eorzes/PSLink_v2/PCB-3D.png

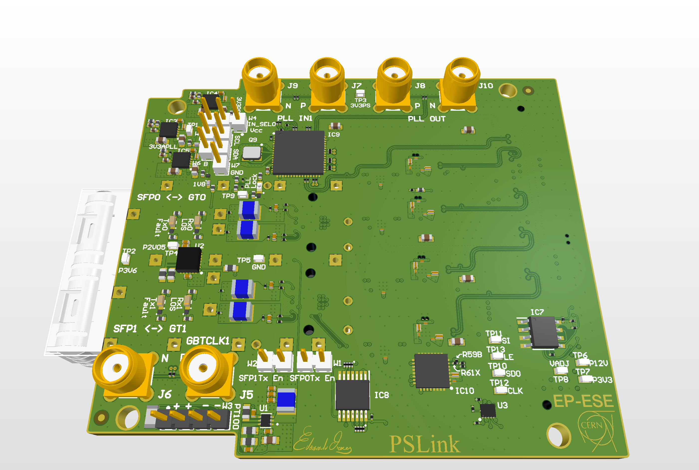
PCB-3D.png
