eorzes/PSLink_v2/PCB-3D-bot.png

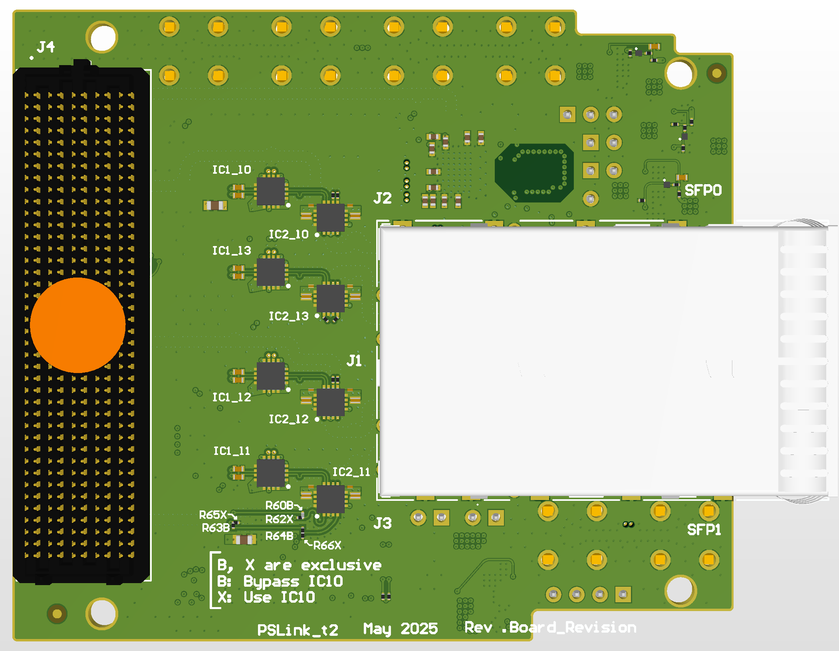
PCB-3D-bot.png
