eorzes/PSLink_v2/BOM_PSLink_v2.csv

Designator | Quantity | Manufacturer | Description | Comment | Footprint | Package | LibRef
C1_l0, C1_l1, C1_l2, C1_l3, C3_l0, C3_l1, C3_l2, C3_l3, C5_l0, C5_l1, C5_l2, C5_l3, C8_l0, C8_l1, C8_l2, C8_l3, C19, C32, C41, C104 | 20 |  | LLL153C70G474ME17 | 470nF | CAPC0510X04N |  | Capacitor - non polarized
C2_l0, C2_l1, C2_l2, C2_l3, C4_l0, C4_l1, C4_l2, C4_l3, C6_l0, C6_l1, C6_l2, C6_l3, C9_l0, C9_l1, C9_l2, C9_l3, C12_l0, C12_l1, C12_l2, C12_l3, C13_l0, C13_l1, C13_l2, C13_l3, C105 | 25 |  | LLL03TR61E333KE01 | 33nF | LLL03TR61E333KE01 |  | Capacitor - non polarized
C7_l0, C7_l1, C7_l2, C7_l3, C15, C16, C26, C27, C28, C37, C38, C101, C102, C103 | 14 | GENERIC | C1608X5R1E106M080AC | 10uF | CAPC1608X87N |  | CC0603_10UF_6.3V_20%_X5R
C10_l0, C10_l1, C10_l2, C10_l3, C11_l0, C11_l1, C11_l2, C11_l3, C18, C24, C25, C31, C34, C35, C36, C40, C46, C49, C52, C55 | 20 |  | GRM155R60J226ME11 | 22uF | MURATA_HI_DENSITY_0402_CAP |  | C0402-22uF-high-density
C14, C45, C47, C48, C50, C51, C53, C54, C56, C57, C58, C59, C60, C61, C62, C63, C64, C65, C66, C67, C68, C69, C70, C71, C72, C73, C74, C75, C76, C77, C78, C79, C80, C81, C82, C83, C84, C85, C86, C91, C92, C106, C107 | 43 |  | GRM033R61C104KE14 | 100nF | MURATA_HI_DENSITY_0201 |  | C0201-100nF-high-density
C17, C20, C30, C33, C39, C42, C87, C88, C89, C90, C93, C94, C95, C96, C97, C98, C99, C100 | 18 | GENERIC | GRM153B30J105ME15 | 1uF | CAPC1005X55N |  | CC0402_1UF_16V_10%_X5R
C21, C22, C23 | 3 |  | GRM155R71E104KE14 | 100nF | MURATA_HI_DENSITY_0402_CAP |  | C0402-22uF-high-density
C29, C43, C44 | 3 |  | C0402C220J4GACTU | 22pF | MURATA_HI_DENSITY_0402_CAP |  | C0402-22uF-high-density
D1, D2, D3 | 3 |  | Led Green 0402 2mA 2.65V 40mcd 102mW | APHHS1005LZGCK-V | LED_APHHS1005LZGCK-V | 0402 Kingbright Corporation | APHHS1005LZGCK-V
D4 | 1 |  | LED | APTD1608LVBC_D | LEDC1608X110N |  | APTD1608LVBC_D
FTG1, FTG2, FTG3, FTG4 | 4 |  | Fiducial Target | Use only in PCB | FIDUCIAL_TOP_C100-200 |  | FIDUCIAL_TARGET_C100-200
IC1_l0, IC1_l1, IC1_l2, IC1_l3 | 4 |  | Integrated Circuit | NB7V52MMNG | QFN50P300X300X100-17N |  | NB7V52MMNG
IC2_l0, IC2_l1, IC2_l2, IC2_l3 | 4 |  | Integrated Circuit | NB7VQ14MMNHTBG | QFN50P300X300X100-17N |  | NB7VQ14MMNHTBG
IC3, IC4, IC5 | 3 |  | Integrated Circuit | ADP7159ACPZ-04-R7 | SON50P300X300X85-11N-D |  | ADP7159ACPZ-04-R7
IC6 | 1 |  | 32207590 - PT100 - 1206 - 0.3degC - -50/130 | 32207590 | PT100 |  | PT100
IC7 | 1 |  | Integrated Circuit | M24C02-RMN6TP | SOIC127P600X175-8N |  | M24C02-RMN6TP
IC8 | 1 |  | Integrated Circuit | TCA9543APWR | SOP65P640X120-14N |  | TCA9543APWR
IC9 | 1 |  | Integrated Circuit | SI5345B-D-GM | QFN50P900X900X90-65N-D |  | SI5345B-D-GM
IC10 | 1 |  | Integrated Circuit | PE44820B-X | QFN50P500X500X90-33N-D |  | PE44820B-X
J1 | 1 |  | Connector | 2007263-1_NP | 20072631_NP |  | 2007263-1_NP
J2, J3 | 2 | TYCO ELECTRONICS | 20 Position SFP+ Connector (Small Form-factor Pluggable) | SFP+ | TYCO_1888247-1 |  | TYCO_1888247-1
J4 | 1 |  |  | SEAM-40-03.5-S-10-2-A-K-TR | SAMTEC_SEAM-40-03.5-S-10-2-A-K-TR | None | SEAM-40-03.5-S-10-2-A-K-TR
J5, J6, J7, J8, J9, J10 | 6 | SAMTEC |  | SMA | SAMTEC_SMA-J-P-H-ST-MT1 |  | SAMTEC_SMA-J-P-H-ST-MT1
L1, L2, L3, L4, L5 | 5 |  | Inductor | 4.7uH | DFE322520FD1R0MP2 |  | DFE322520FD-4R7M=P2
LED1, LED2, LED3, LED4 | 4 |  | Led Red 0603 2mA 1.8V 50mcd 84mW | APTD1608LSECKJ3-PF | LED_APTD1608LSECKJ3-PF_KNB |  | APTD1608LSECKJ3-PF
Q1, Q2, Q3, Q4, Q5, Q6, Q7, Q8, Q10 | 9 |  | MOSFET (N-Channel) | CSD15380F3 | CSD15380F3 |  | CSD15380F3
Q9 | 1 | KYOCERA | Crystal 4 pins 1=XTAL Control 2=GND3=XTAL 4=GND | 48MHz | XTAL_KYOCERA_CX3225SB |  | XTAL_48MHZ_KYOCERA_CX3225SB48000D0FPJC1
R1, R4, R21, R24, R25, R27 | 6 |  | Resistor 10k | 1M | MURATA_HI_DENSITY_0201 |  | R0201-100ohm-high-density
R2, R22, R26, R50, R51, R52 | 6 |  | Resistor | 100O | MURATA_HI_DENSITY_0201 |  | R0201-100ohm-high-density
R3, R8, R15, R57 | 4 | GENERIC | Resistor - 1% | 750 | RESC1005X40N |  | R0402_750R_1%_0.0625W_100PPM
R5, R11 | 2 | GENERIC | Resistor - 1% | 47k | RESC1005X40N |  | R0402_47K_1%_0.0625W_100PPM
R6, R12 | 2 | GENERIC | Resistor - 1% | 27k | RESC1005X40N |  | R0402_27K_1%_0.0625W_100PPM
R7, R13, R16 | 3 | GENERIC | Resistor - 1% | 100k | RESC1608X55N |  | R0603_30K_1%_0.1W_100PPM
R9 | 1 | GENERIC | Resistor - 1% | 150k | RESC1608X55N |  | R0603_150K_1%_0.1W_100PPM
R10 | 1 | GENERIC | Resistor - 1% | 30k | RESC1608X55N |  | R0603_30K_1%_0.1W_100PPM
R14 | 1 | GENERIC | Resistor - 1% | 243k | RESC1608X55N |  | R0603_30K_1%_0.1W_100PPM
R17, R23, R30, R31, R32, R35, R38, R39, R40, R43, R44, R45, R46, R47, R48, R49, R53, R54 | 18 |  | Resistor 10k | 10k | MURATA_HI_DENSITY_0201 |  | R0201-100ohm-high-density
R18, R33, R34, R41, R42, R58 | 6 | GENERIC | Resistor - 1% | 200k | RESC1005X40N |  | R0402_200K_1%_0.0625W_100PPM
R19 | 1 | GENERIC | Resistor - 1% | 20k | RESC1005X40N |  | R0402_20K_1%_0.0625W_100PPM
R20 | 1 | GENERIC | Resistor - 1% | 5k1 | RESC1005X40N |  | R0402_5K1_1%_0.0625W_100PPM
R28, R29, R36, R37 | 4 | GENERIC | Resistor - 1% | 1k5 | RESC1005X40N |  | R0402_1K5_1%_0.0625W_100PPM
R55, R56 | 2 | GENERIC | Resistor - 1% | 22 | RESC1005X40N |  | R0402_22R_1%_0.0625W_100PPM
R59B, R60B, R61X, R62X, R63B, R64B | 6 |  | Resistor | 0O | MURATA_HI_DENSITY_0201 |  | R0201-100ohm-high-density
R65X, R66X | 2 |  | Resistor | 50O | MURATA_HI_DENSITY_0201 |  | R0201-100ohm-high-density
RN1, RN2 | 2 |  | Resistor Network (8-Pin) 10k | EXB-U18103JX | EXBU18 |  | EXB-U18103JX
TP1, TP2, TP3, TP4, TP5, TP6, TP7, TP8, TP9, TP10, TP11, TP12, TP13 | 13 |  |  | RCU-0C | TP+195X110 | None | RCU-0C
U1 | 1 |  | No Description Available | TPS563203DRLR | SOT_07SDRLR_TEX |  | TPS563203DRLR
U2 | 1 |  | No Description Available | TPSM82866AA0SRDJR | RDJ0023A-MFG |  | XPSM82866AA0SRDJR
U3 | 1 |  | No Description Available | TXB0104RUTR | RUT12_TEX |  | TXB0104RUTR
W1, W2, W5, W6 | 4 | SAMTEC | 2 Mini Wire-Wrap Contact Strip Header | Header 2 | SAMTEC_HTSW-102-23-L-S |  | SAMTEC_HTSW-102-23-L-S
W3 | 1 | SAMTEC | 4 Mini Wire-Wrap Contact Strip Header | Header 4 | SAMTEC_HTSW-104-23-L-S |  | SAMTEC_HTSW-104-23-L-S
W4 | 1 | SAMTEC | 3 Mini Wire-Wrap Contact Strip Header | Header 3 | SAMTEC_HTSW-103-23-L-S |  | SAMTEC_HTSW-103-23-L-S
W7 | 1 | SAMTEC | Single Mini Wire-Wrap Contact | Header 1 | SAMTEC_HTSW-101-23-L-S |  | SAMTEC_HTSW-101-23-L-S
