eorzes/PSLink_v2/PSLink_v2.pdf

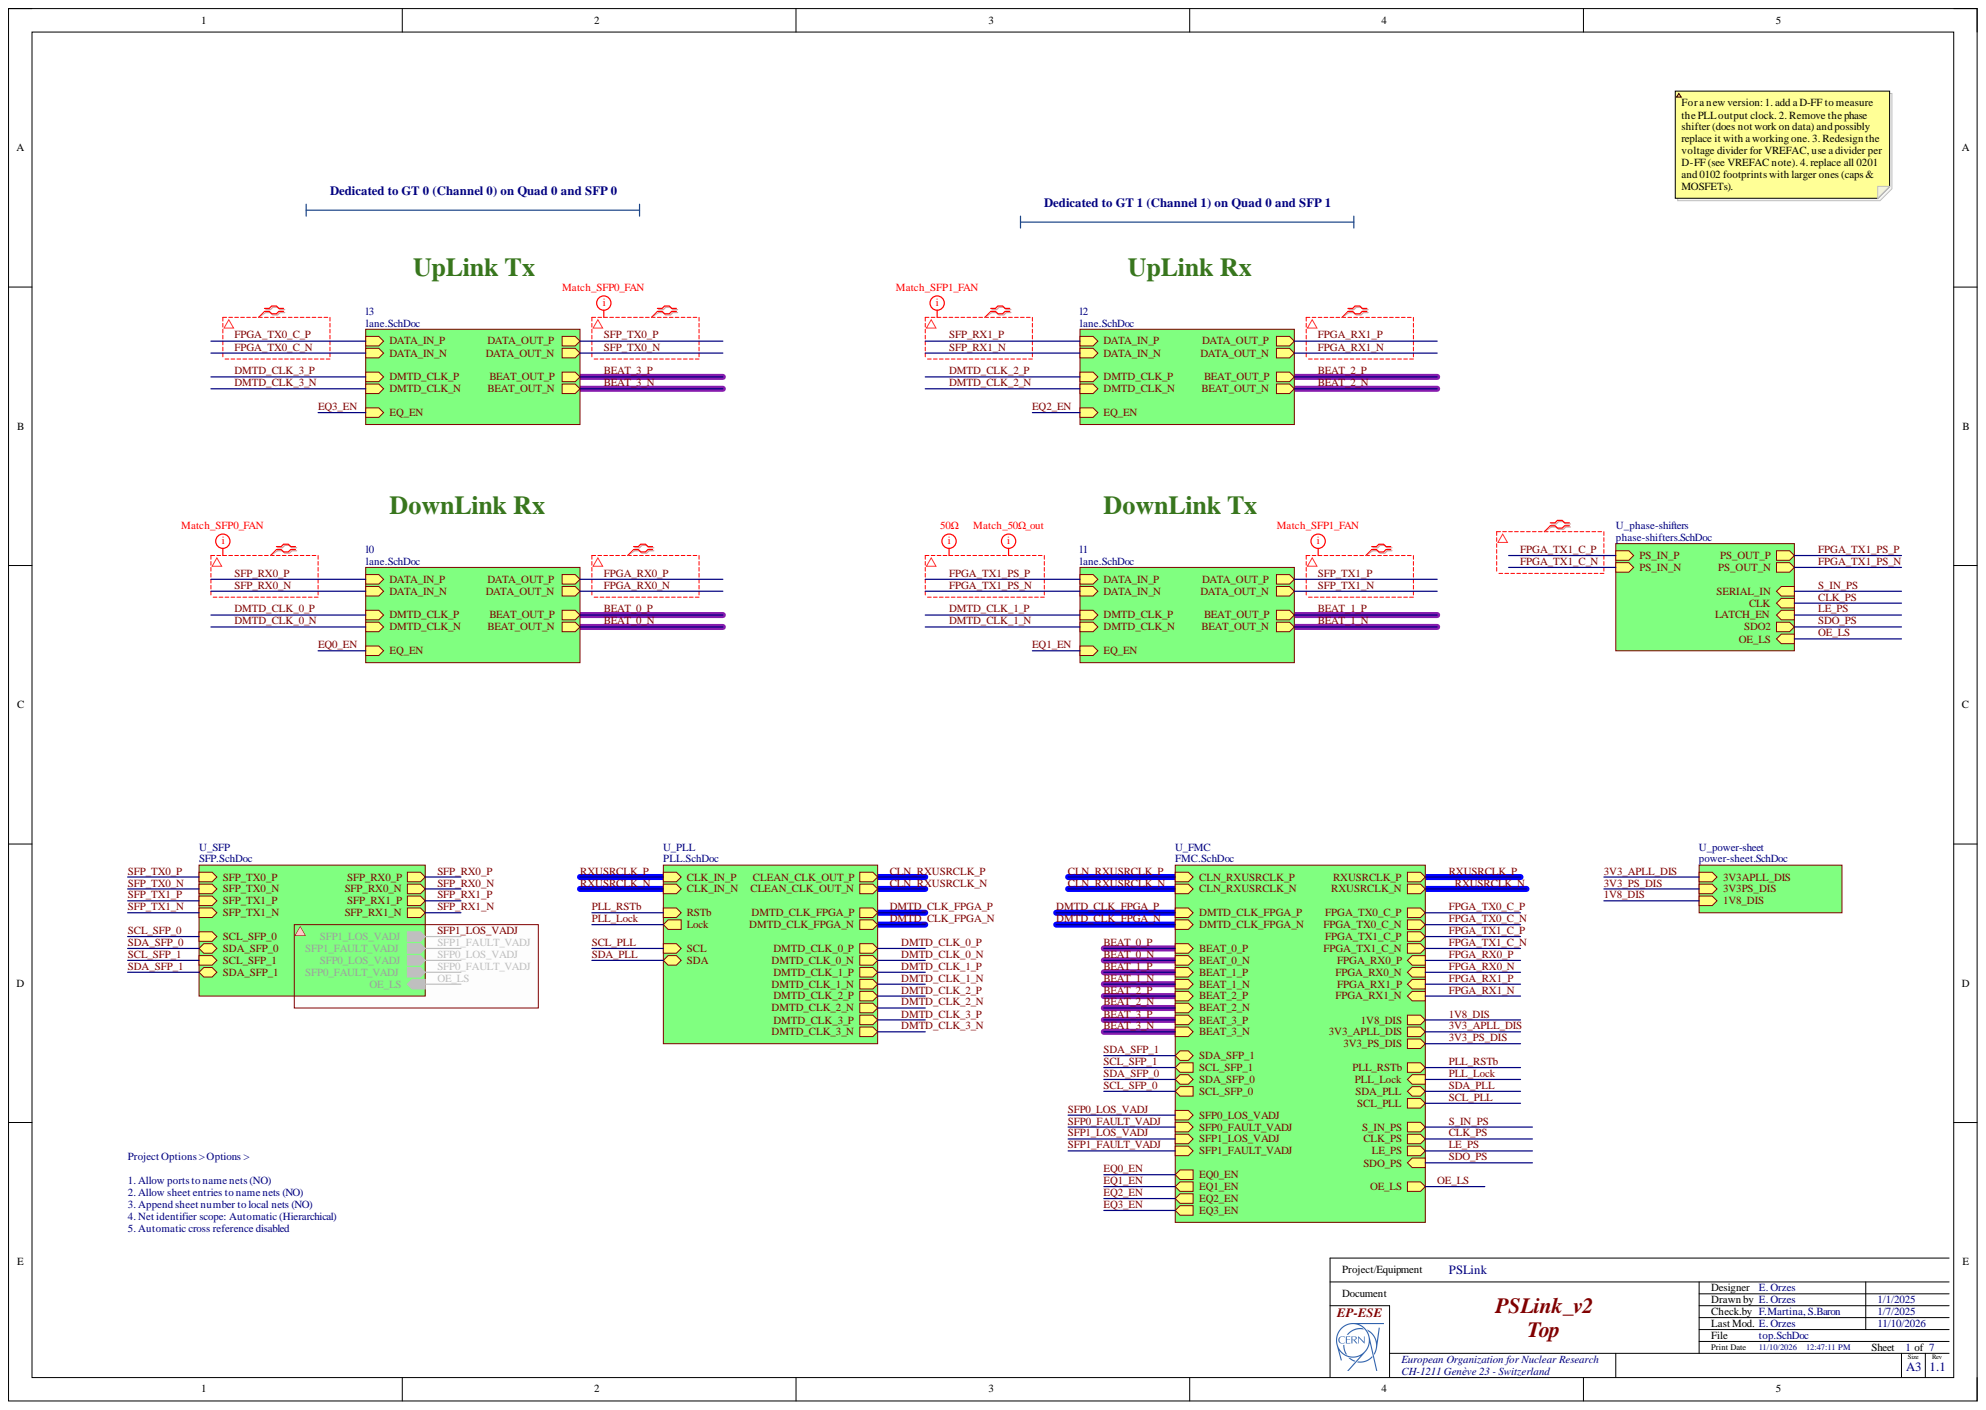
[picture p6: page 1]

For a new version: 1. add a D-FF to measure
the PLLoutput clock. 2. Remove the phase
shifter (does not work on data) and possibly
replace it with a working one. 3. Redesign the
voltage divider for VREFAC, use a divider per
D-FF (see VREFAC note). 4. replace all 0201
and 0102 footprints with larger ones (caps &
MOSFETs).

1. Allow ports to name nets (NO)
2. Allow sheet entries to name nets (NO)
3. Append sheet number to local nets (NO)
4. Net identifier scope: Automatic (Hierarchical)
5. Automatic cross reference disabled

Designer E. Orzes
Drawn by E. Orzes
Check.by F.Martina, S.Baron

European Organization for Nuclear Research
CH-1211 Genève 23 - Switzerland

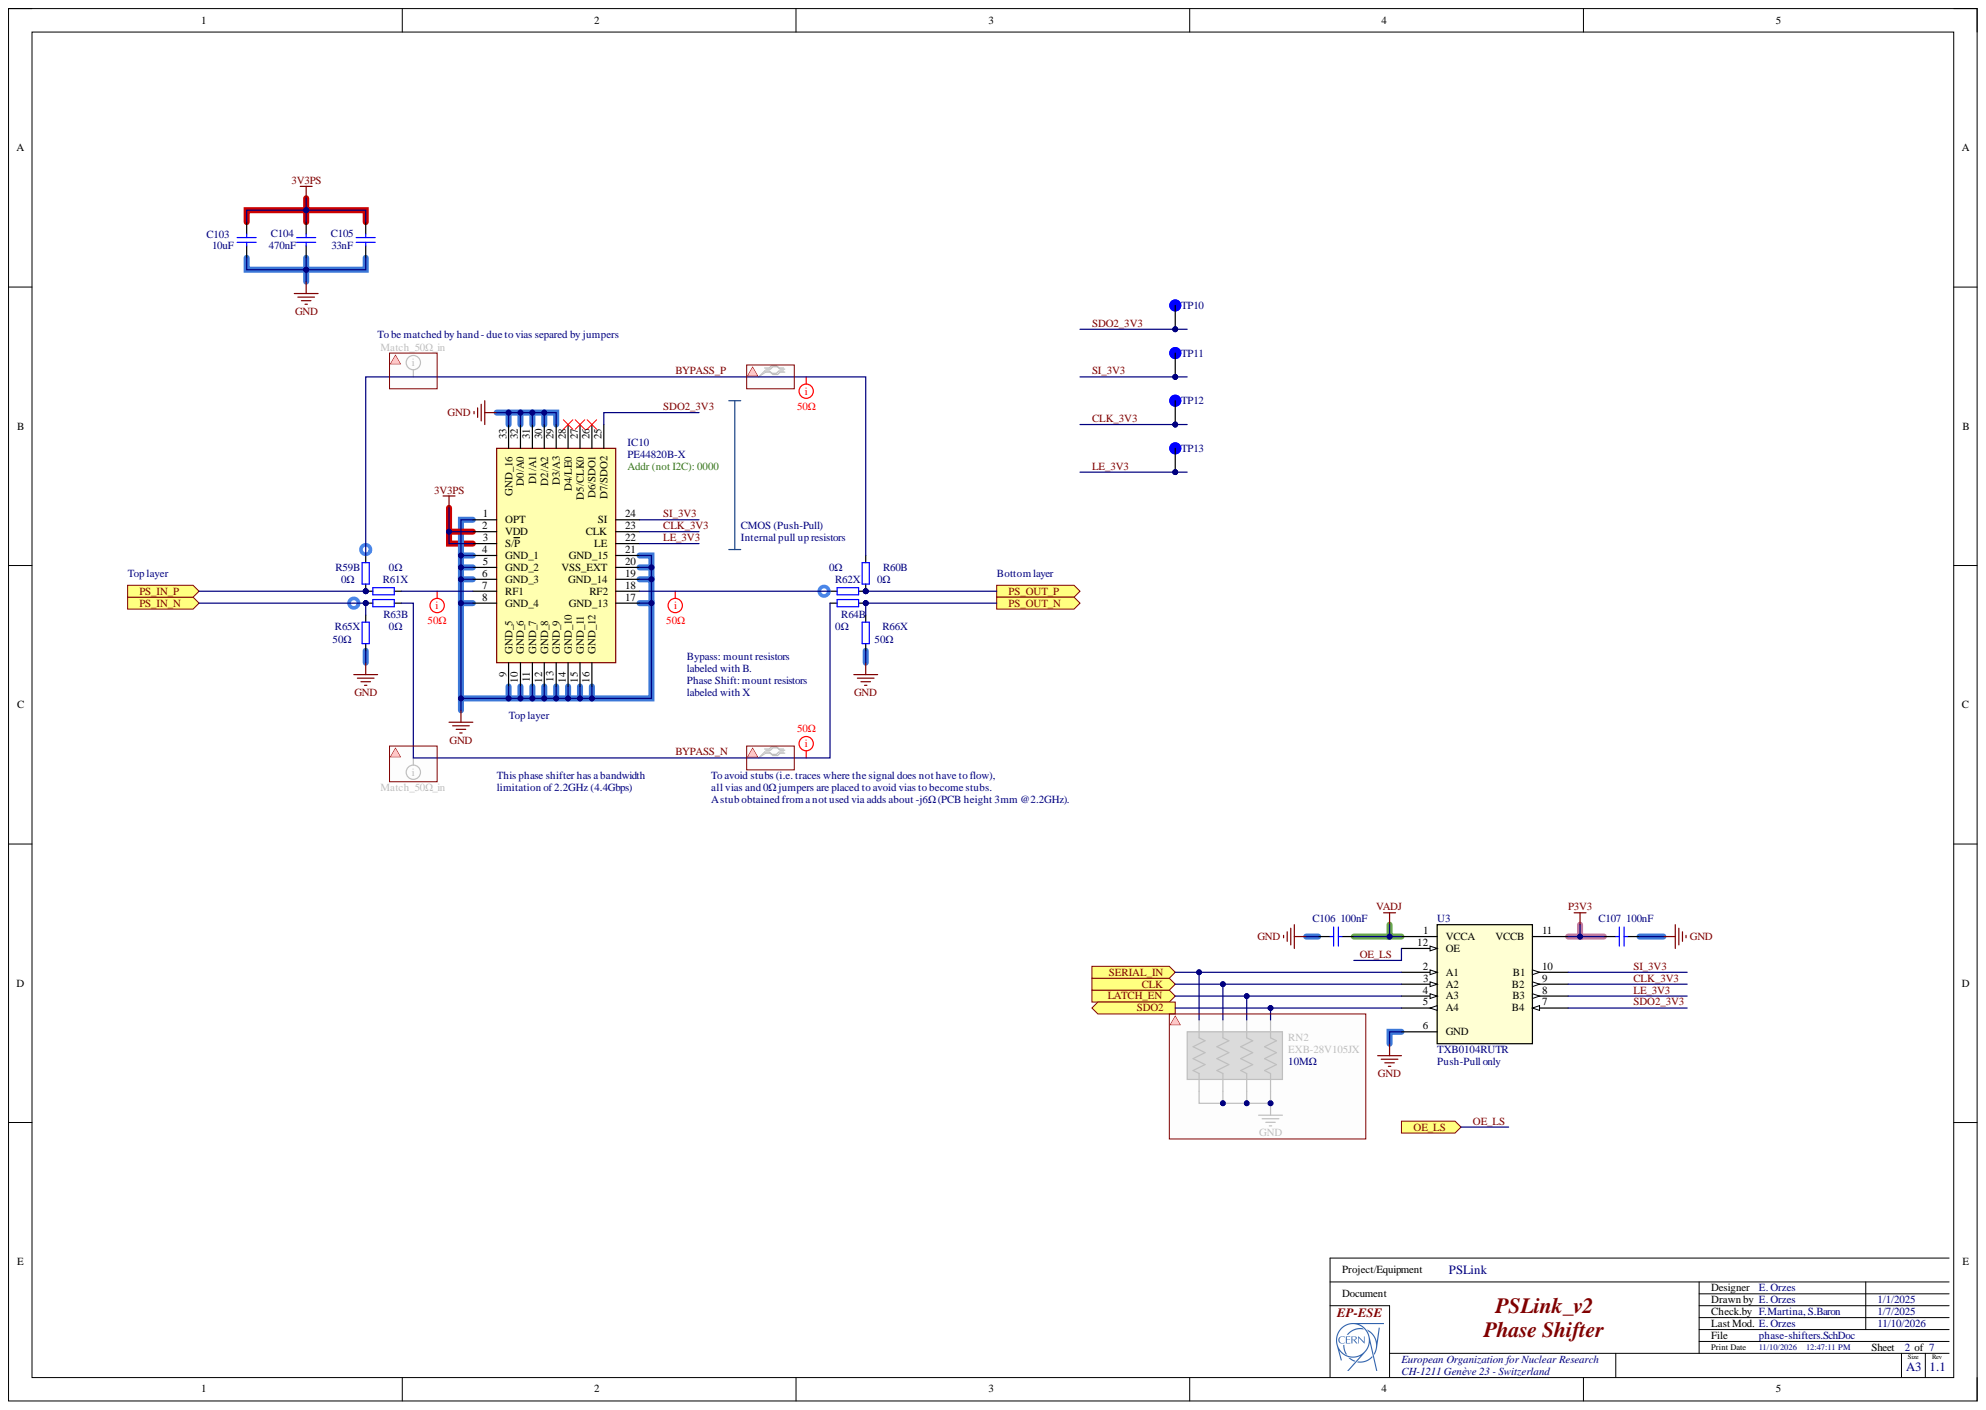
[picture p7: page 2]

To be matched by hand - due to vias separed by jumpers
Match_50Ω_in

CMOS (Push-Pull)
Internal pull up resistors

GND_1 4
GND_2 5 VSS_EXT GND_14 RF2 GND_13 | 20 | 0Ω
GND_3 6 | 19
RF1 7 | 18
GND_4 8 | 17

Bypass: mount resistors
labeled with B.
Phase Shift: mount resistors
labeled with X

This phase shifter has a bandwidth
limitation of 2.2GHz (4.4Gbps)

To avoid stubs (i.e. traces where the signal does not have to flow),
all vias and 0Ωjumpers are placed to avoid vias to become stubs.
Astub obtained from a not used via adds about -j6Ω(PCB height 3mm @2.2GHz).

GND 6

Designer E. Orzes
Drawn by E. Orzes
Check.by F.Martina, S.Baron

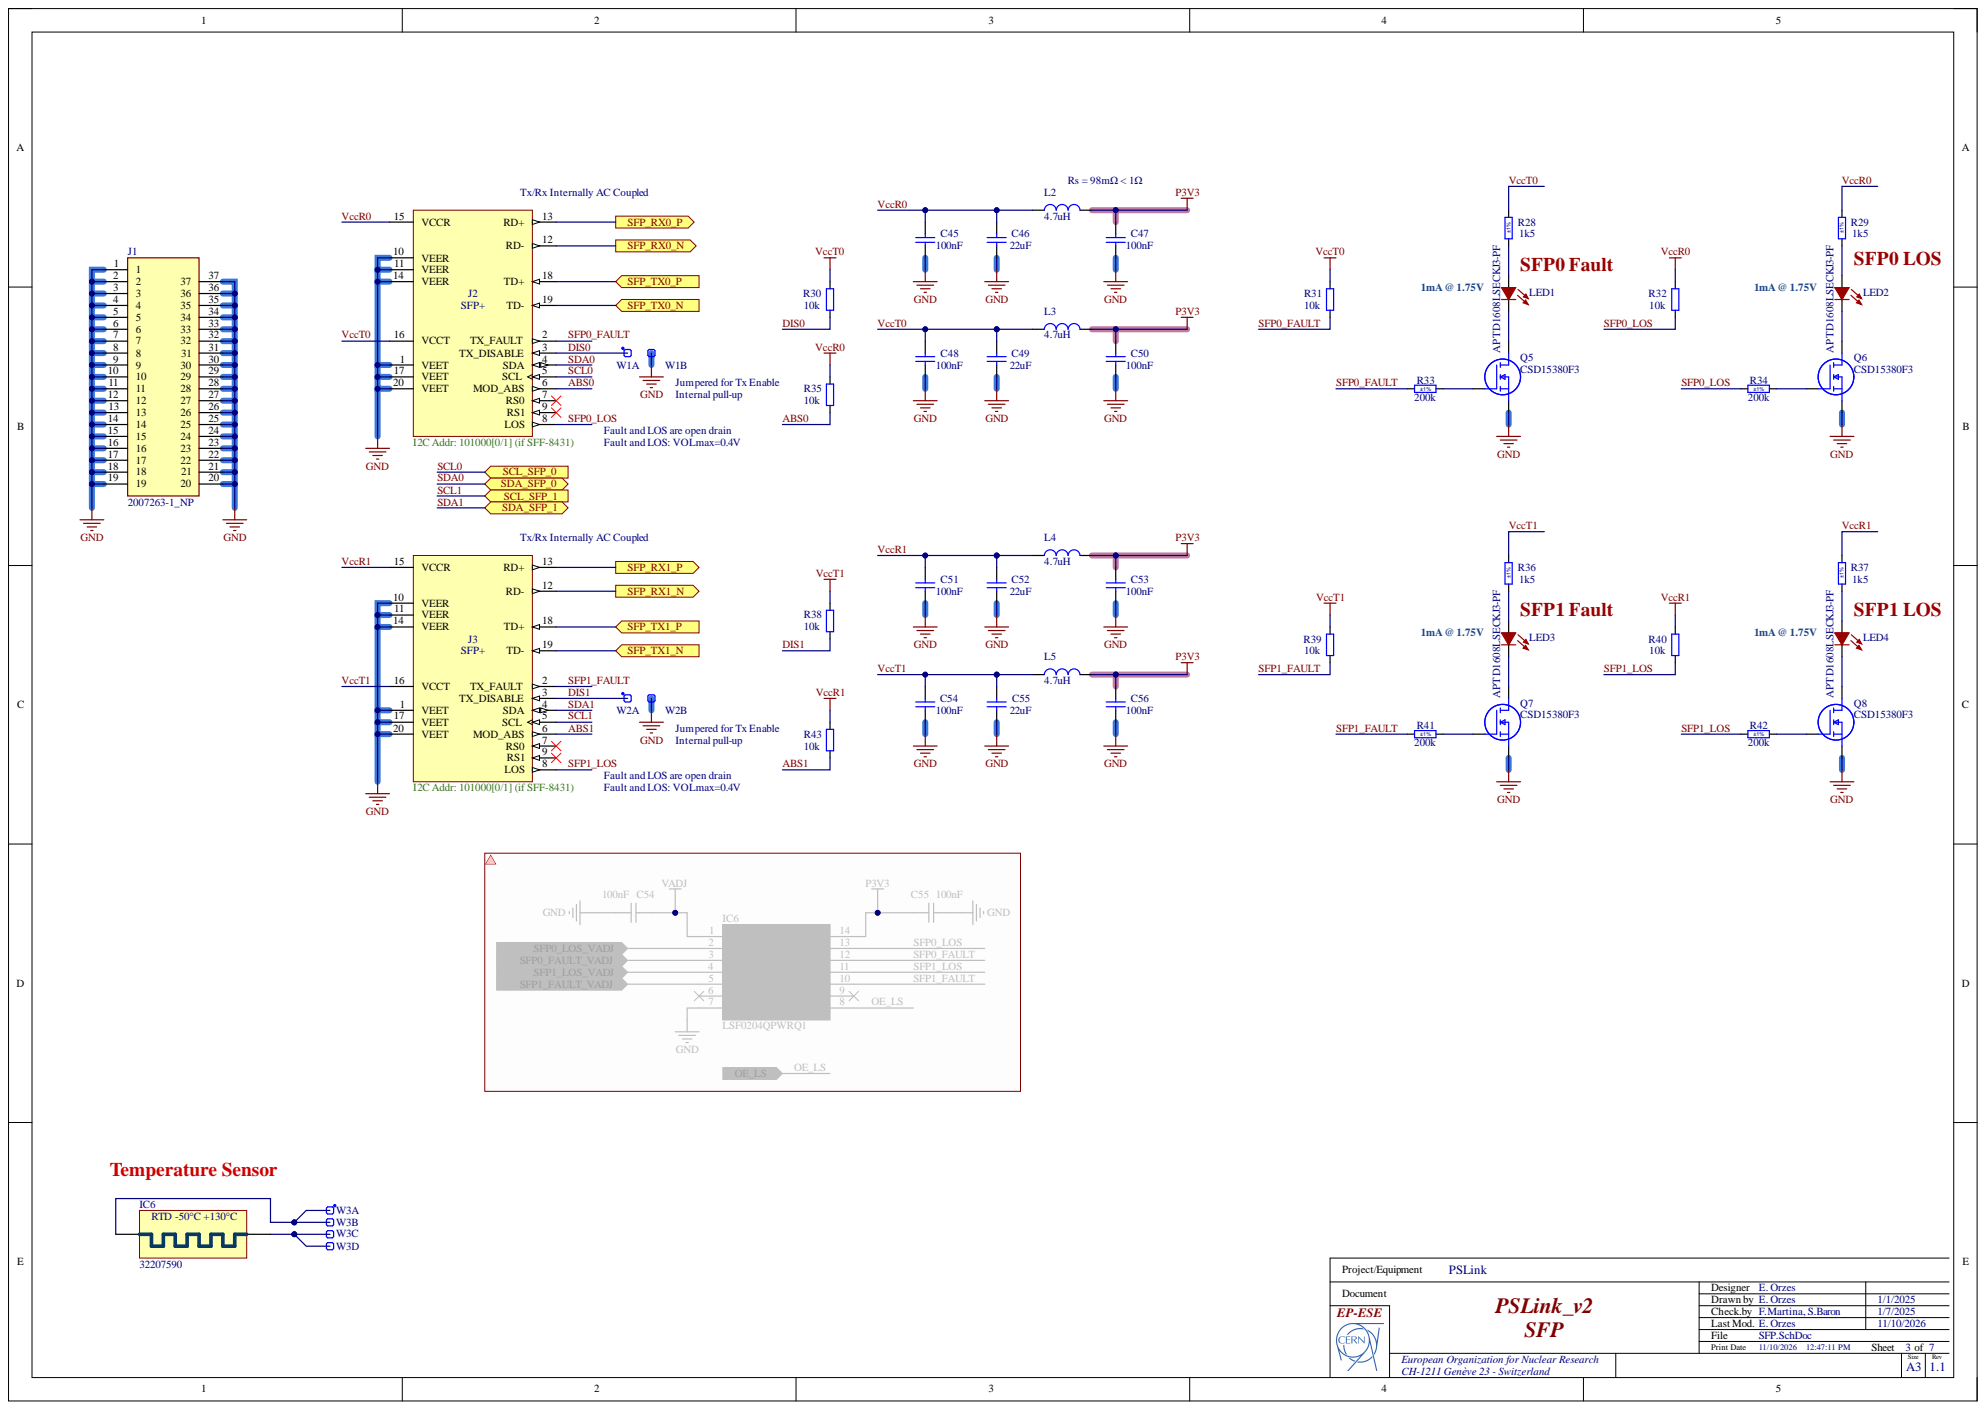
[picture p8: page 3]

I2C Addr: 101000[0/1] (if SFF-8431)

mpered for Tx Enabl

Fault and LOS are open drain
Fault and LOS: VOLmax=0

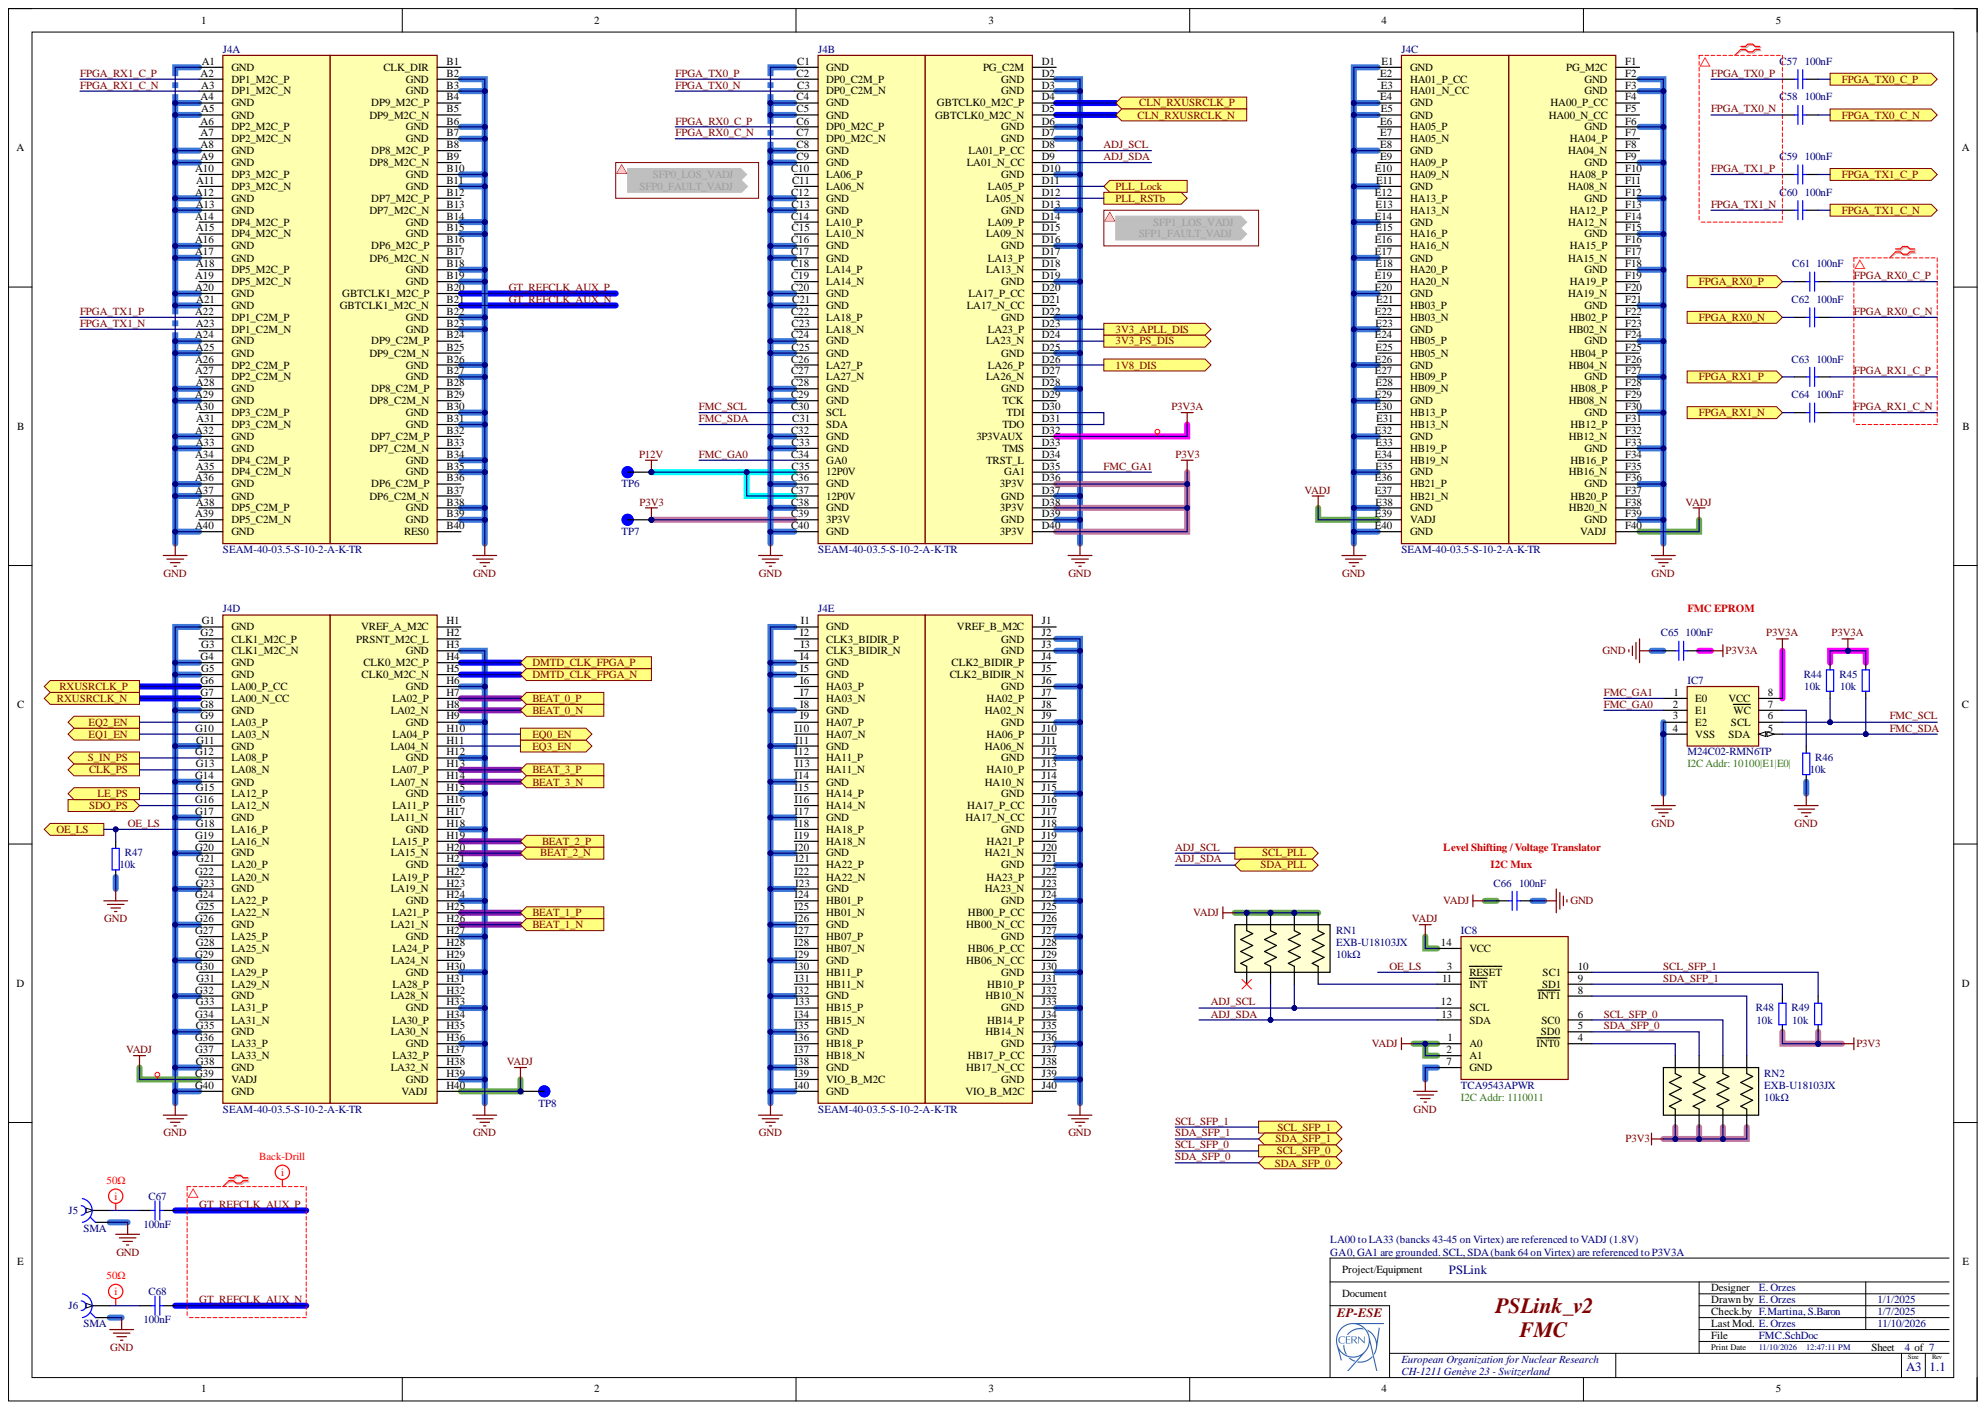
[picture p9: page 4]

Level Shifting / Voltage Translator

LA00 to LA33 (bancks 43-45 on Virtex) are referenced to VADJ (1.8V)
GA0, GA1 are grounded. SCL, SDA (bank 64 on Virtex) are referenced to P3V3A

Designer E. Orzes
Drawn by E. Orzes
Check.by F.Martina, S.Baron

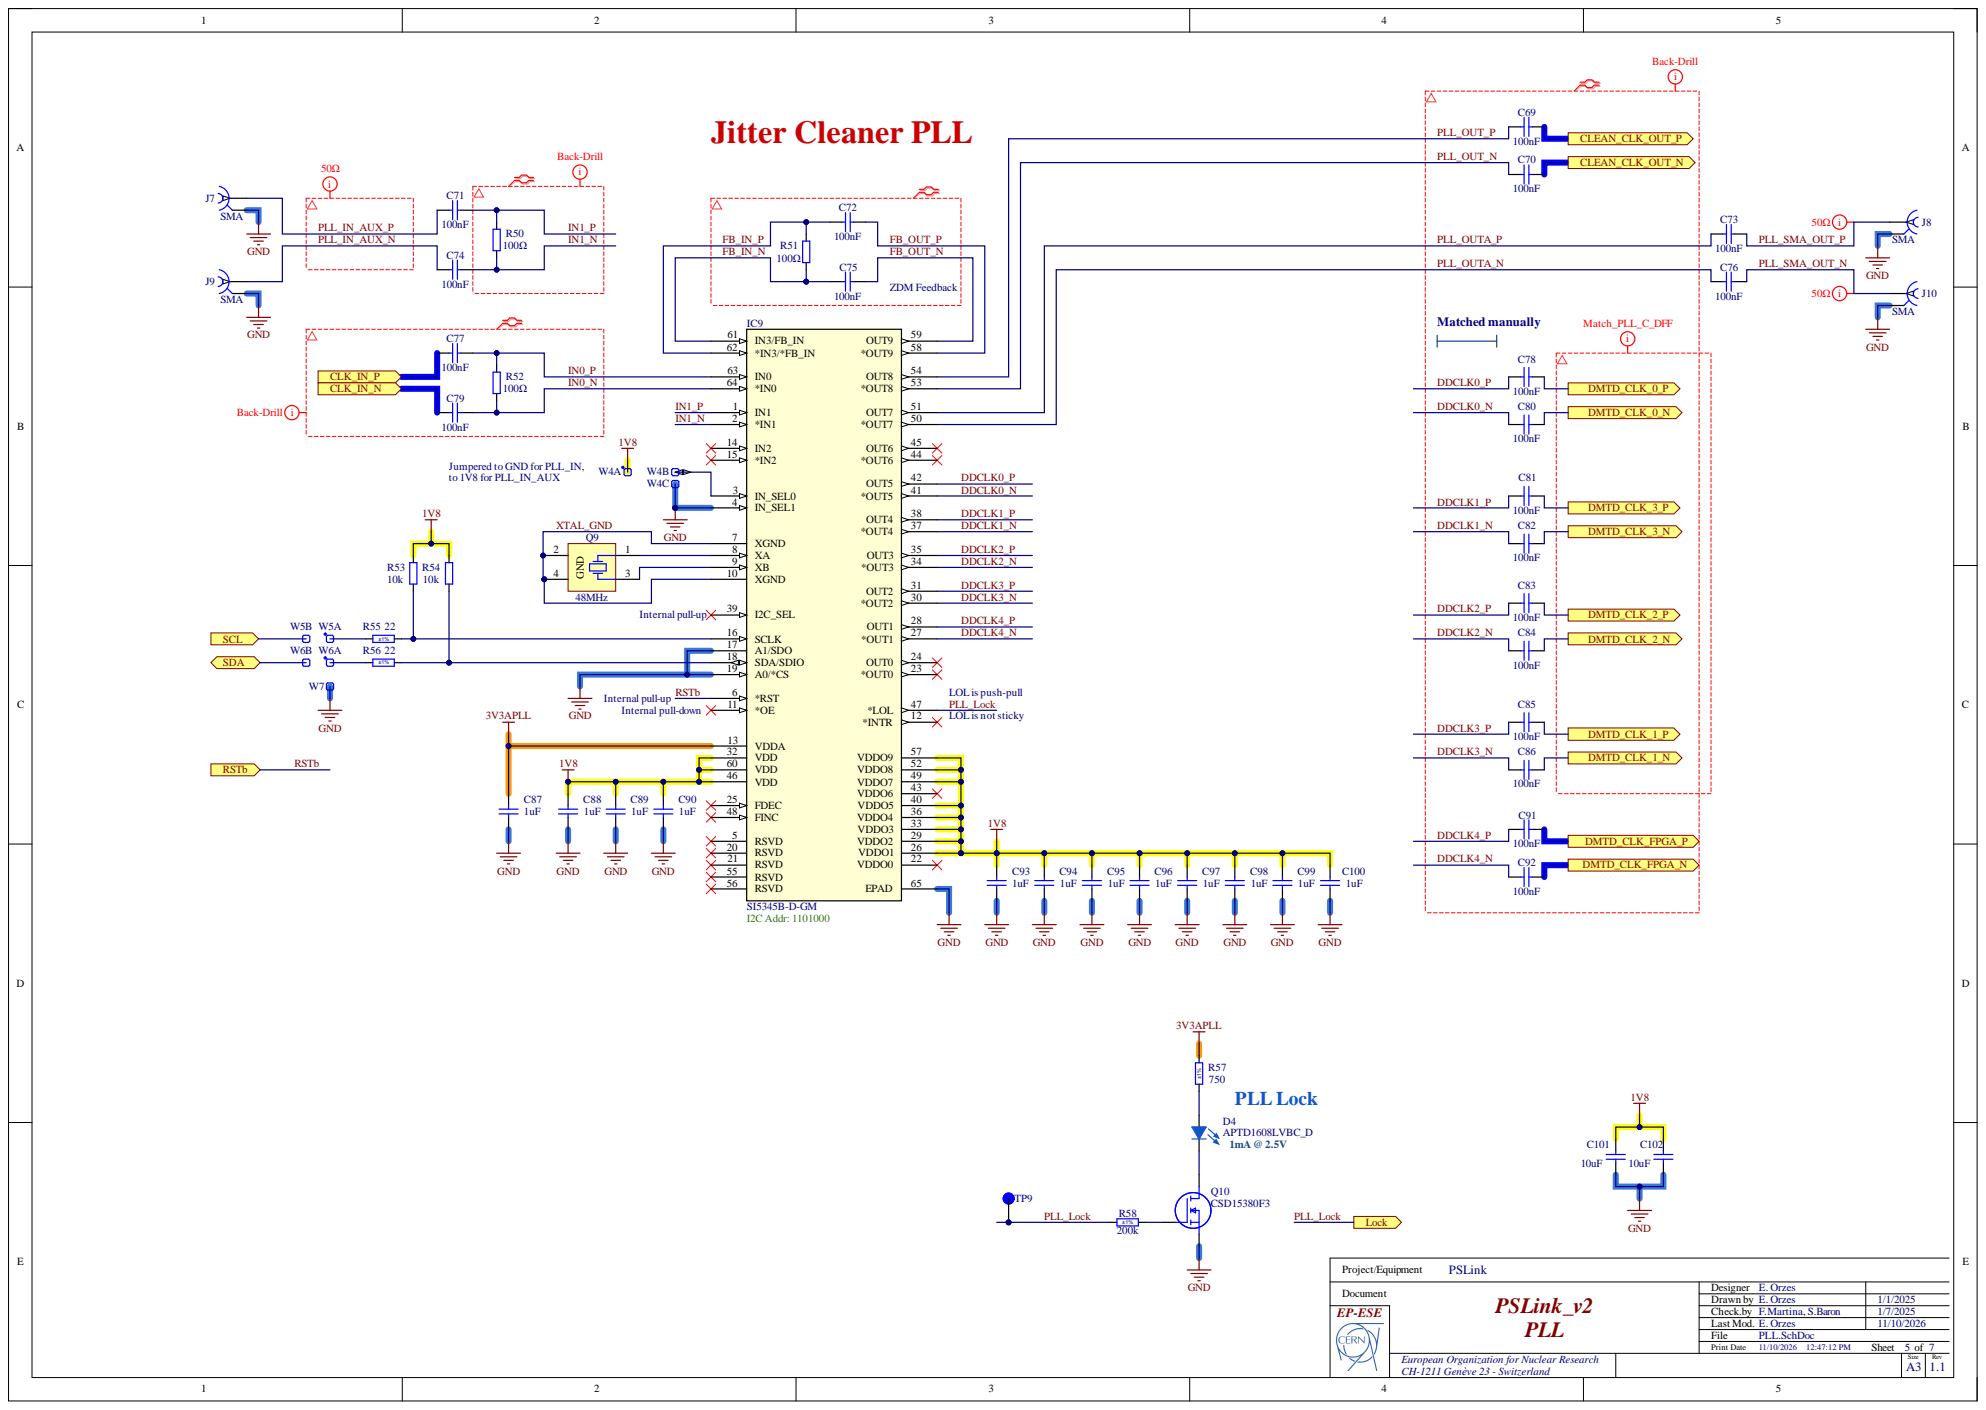
[picture p10: page 5]

IN0_N | *IN0 64 | | DDCLK0_P

IN1_P | | IN1 1 | DDCLK0_N

Jumpered to GND for PLL_IN,

A1/SDO 17
SDA/SDIO 18

Designer E. Orzes
Drawn by E. Orzes
Check.by F.Martina, S.Baron

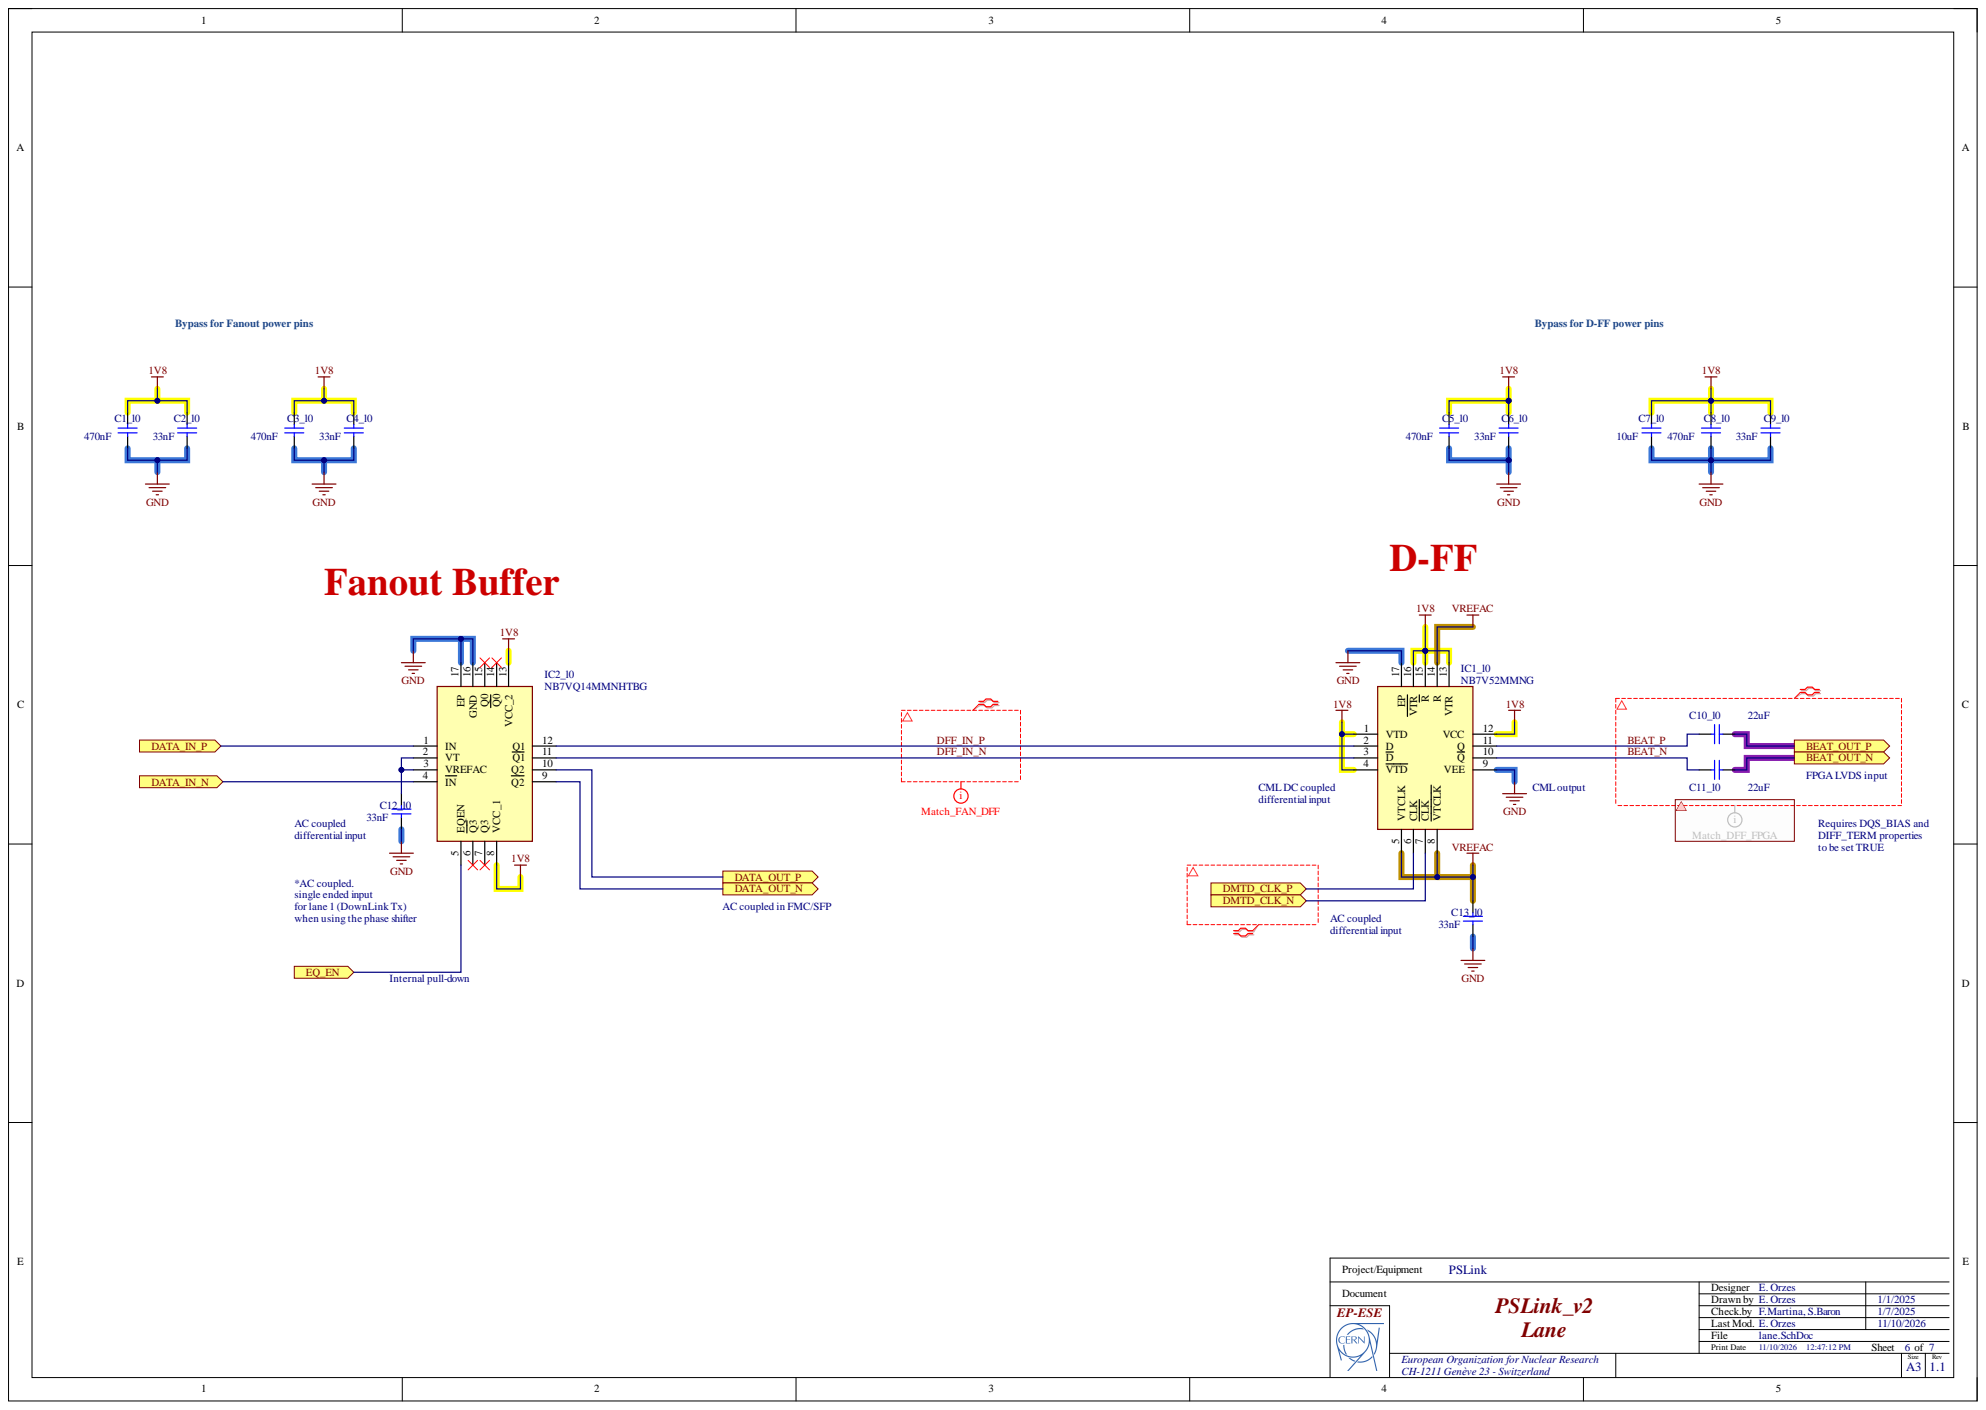
[picture p11: page 6]

Bypass for Fanout power pins

Bypass for D-FF power pins

Requires DQS_BIAS and
DIFF_TERM properties
to be set TRUE

*AC coupled.
single ended input
for lane 1 (DownLink Tx)
when using the phase shifter

Designer E. Orzes
Drawn by E. Orzes
Check.by F.Martina, S.Baron

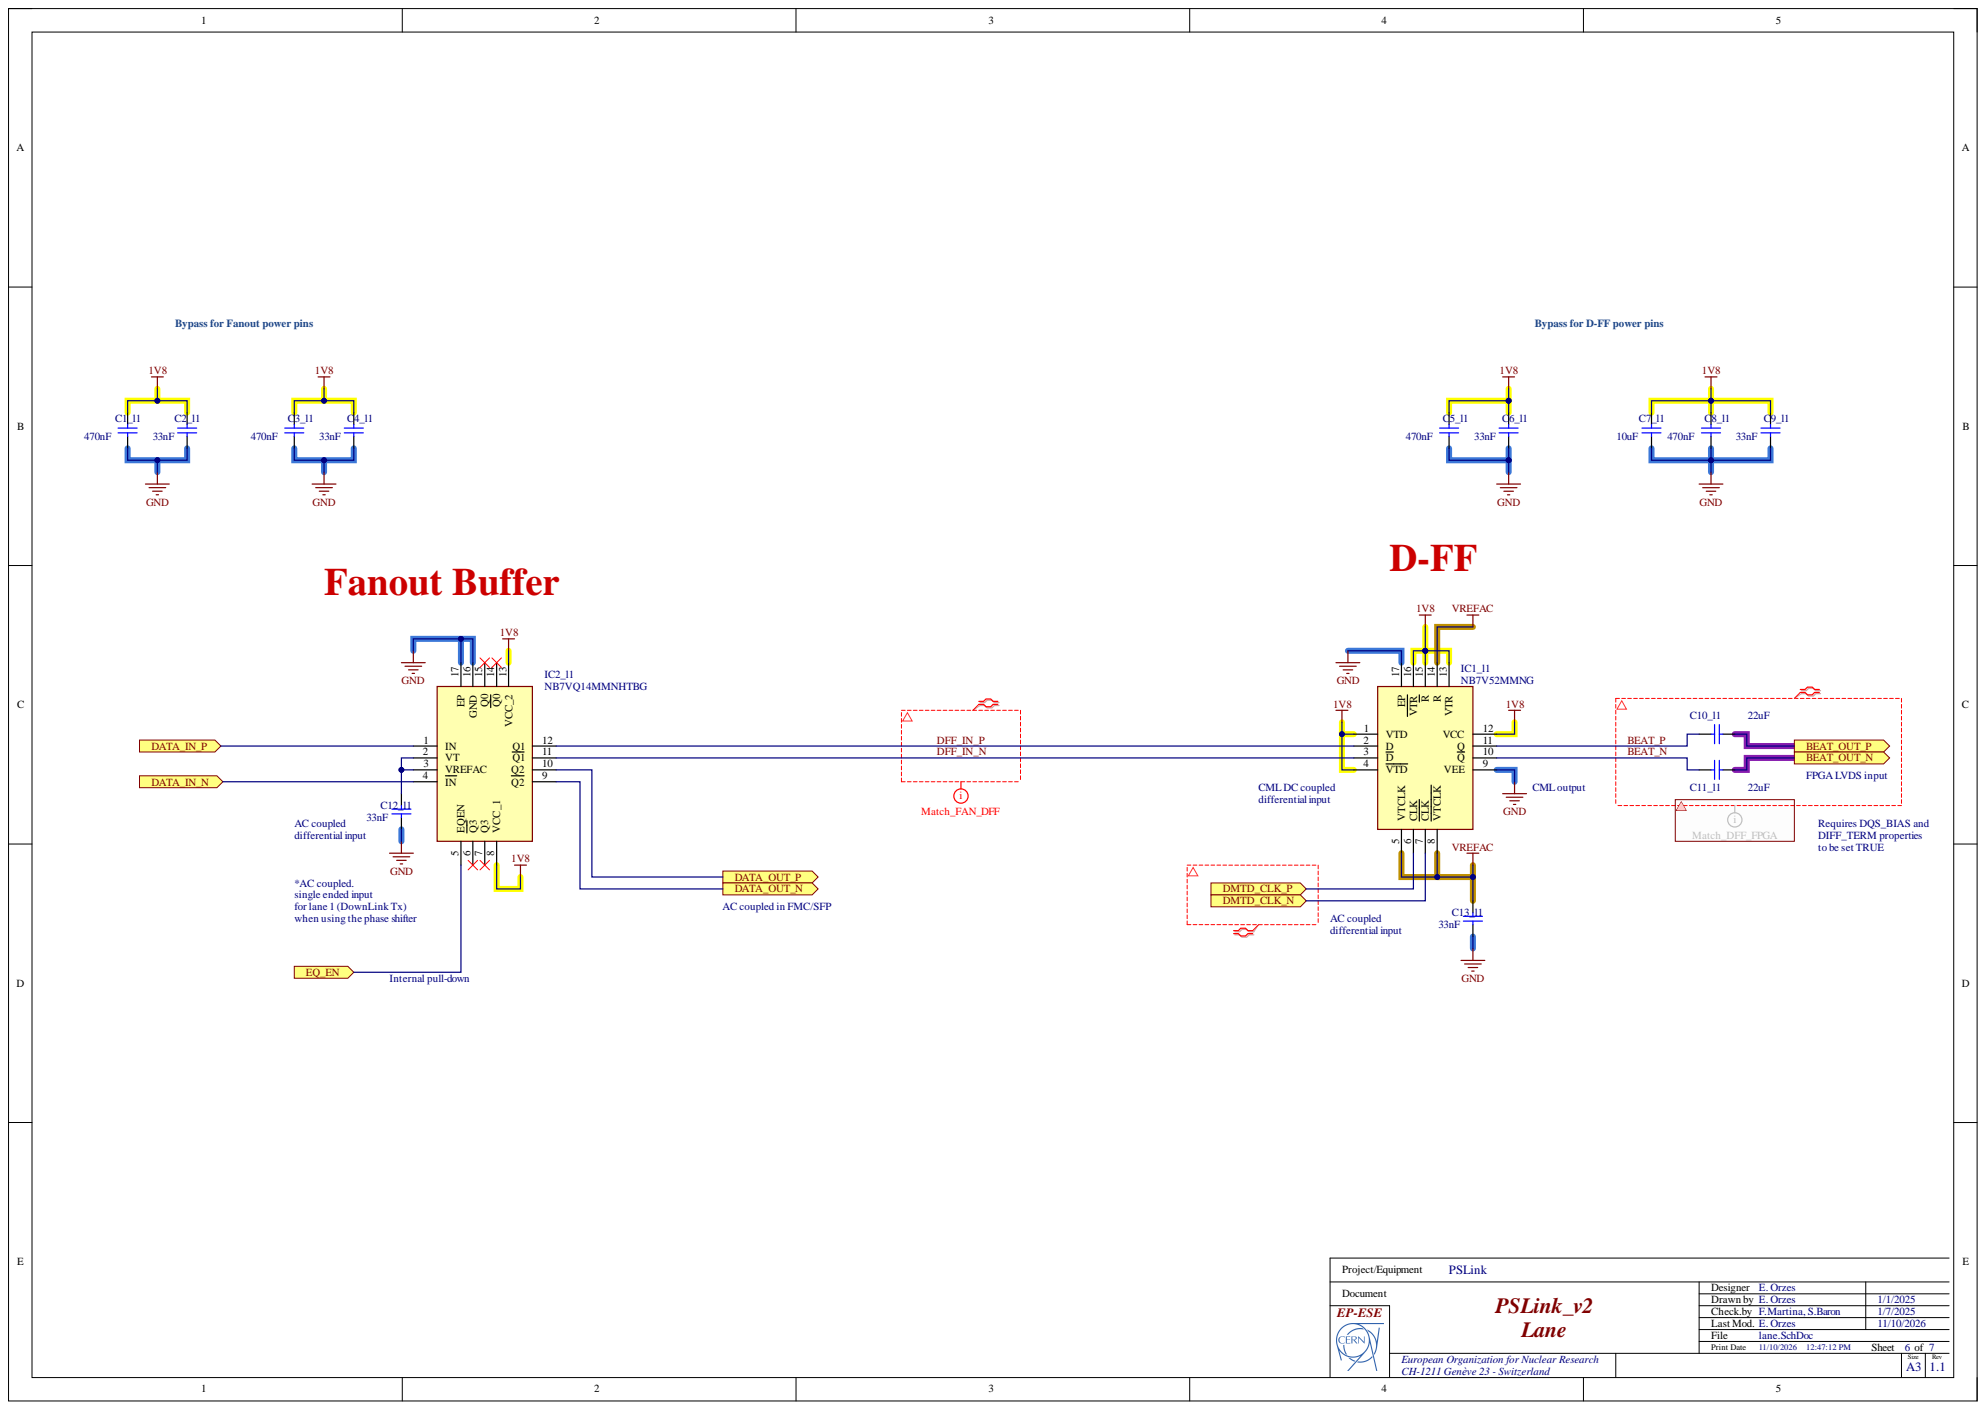
[picture p12: page 7]

Bypass for Fanout power pins

Bypass for D-FF power pins

Requires DQS_BIAS and
DIFF_TERM properties
to be set TRUE

*AC coupled.
single ended input
for lane 1 (DownLink Tx)
when using the phase shifter

Designer E. Orzes
Drawn by E. Orzes
Check.by F.Martina, S.Baron

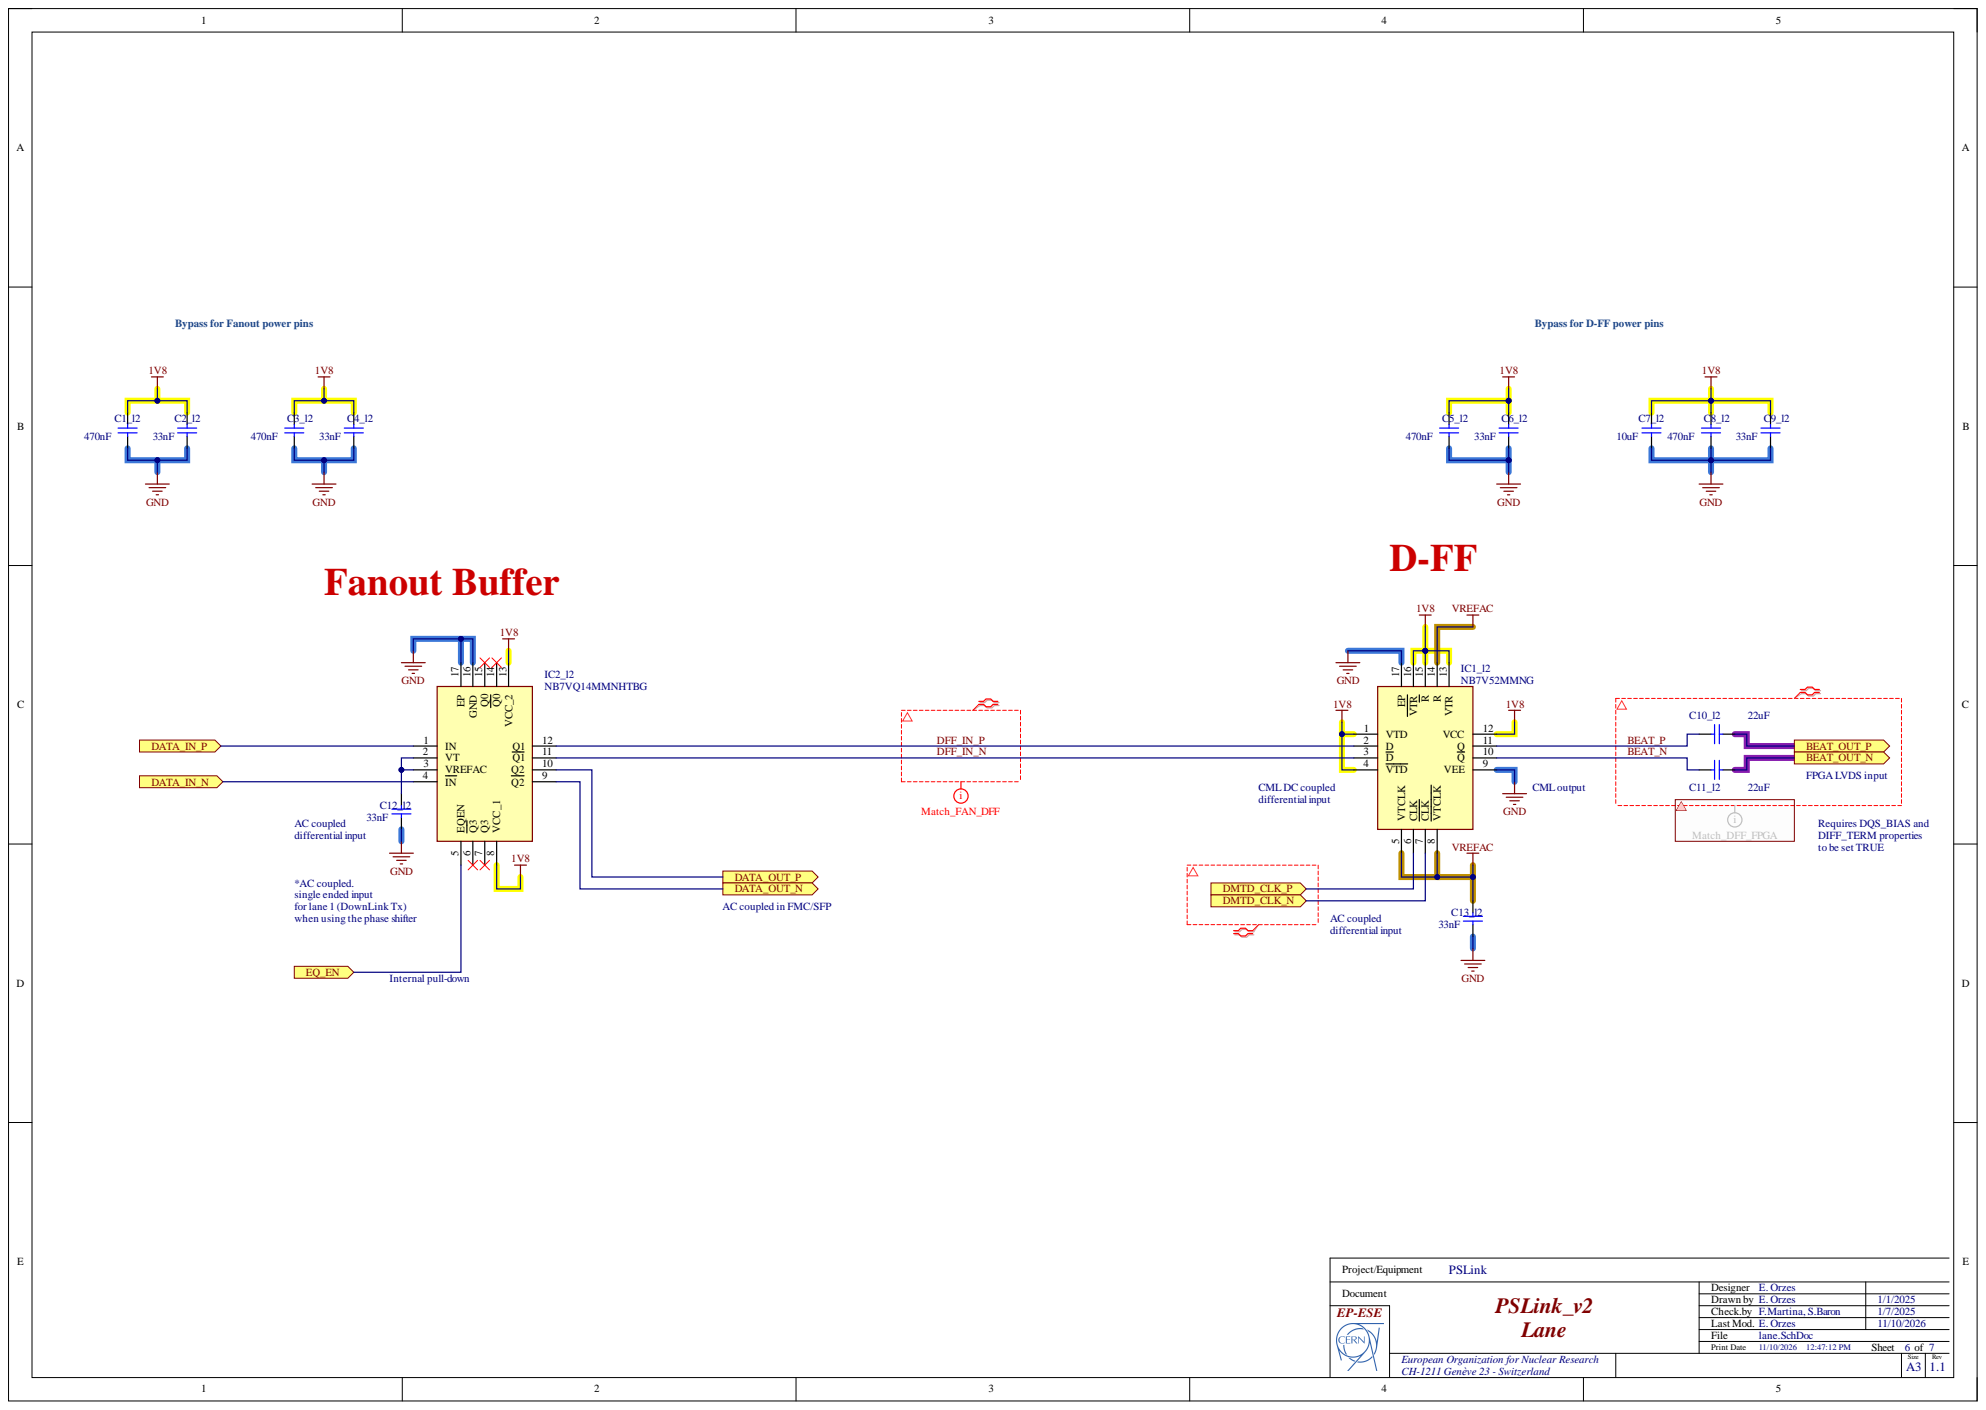
[picture p13: page 8]

Bypass for Fanout power pins

Bypass for D-FF power pins

Requires DQS_BIAS and
DIFF_TERM properties
to be set TRUE

*AC coupled.
single ended input
for lane 1 (DownLink Tx)
when using the phase shifter

Designer E. Orzes
Drawn by E. Orzes
Check.by F.Martina, S.Baron

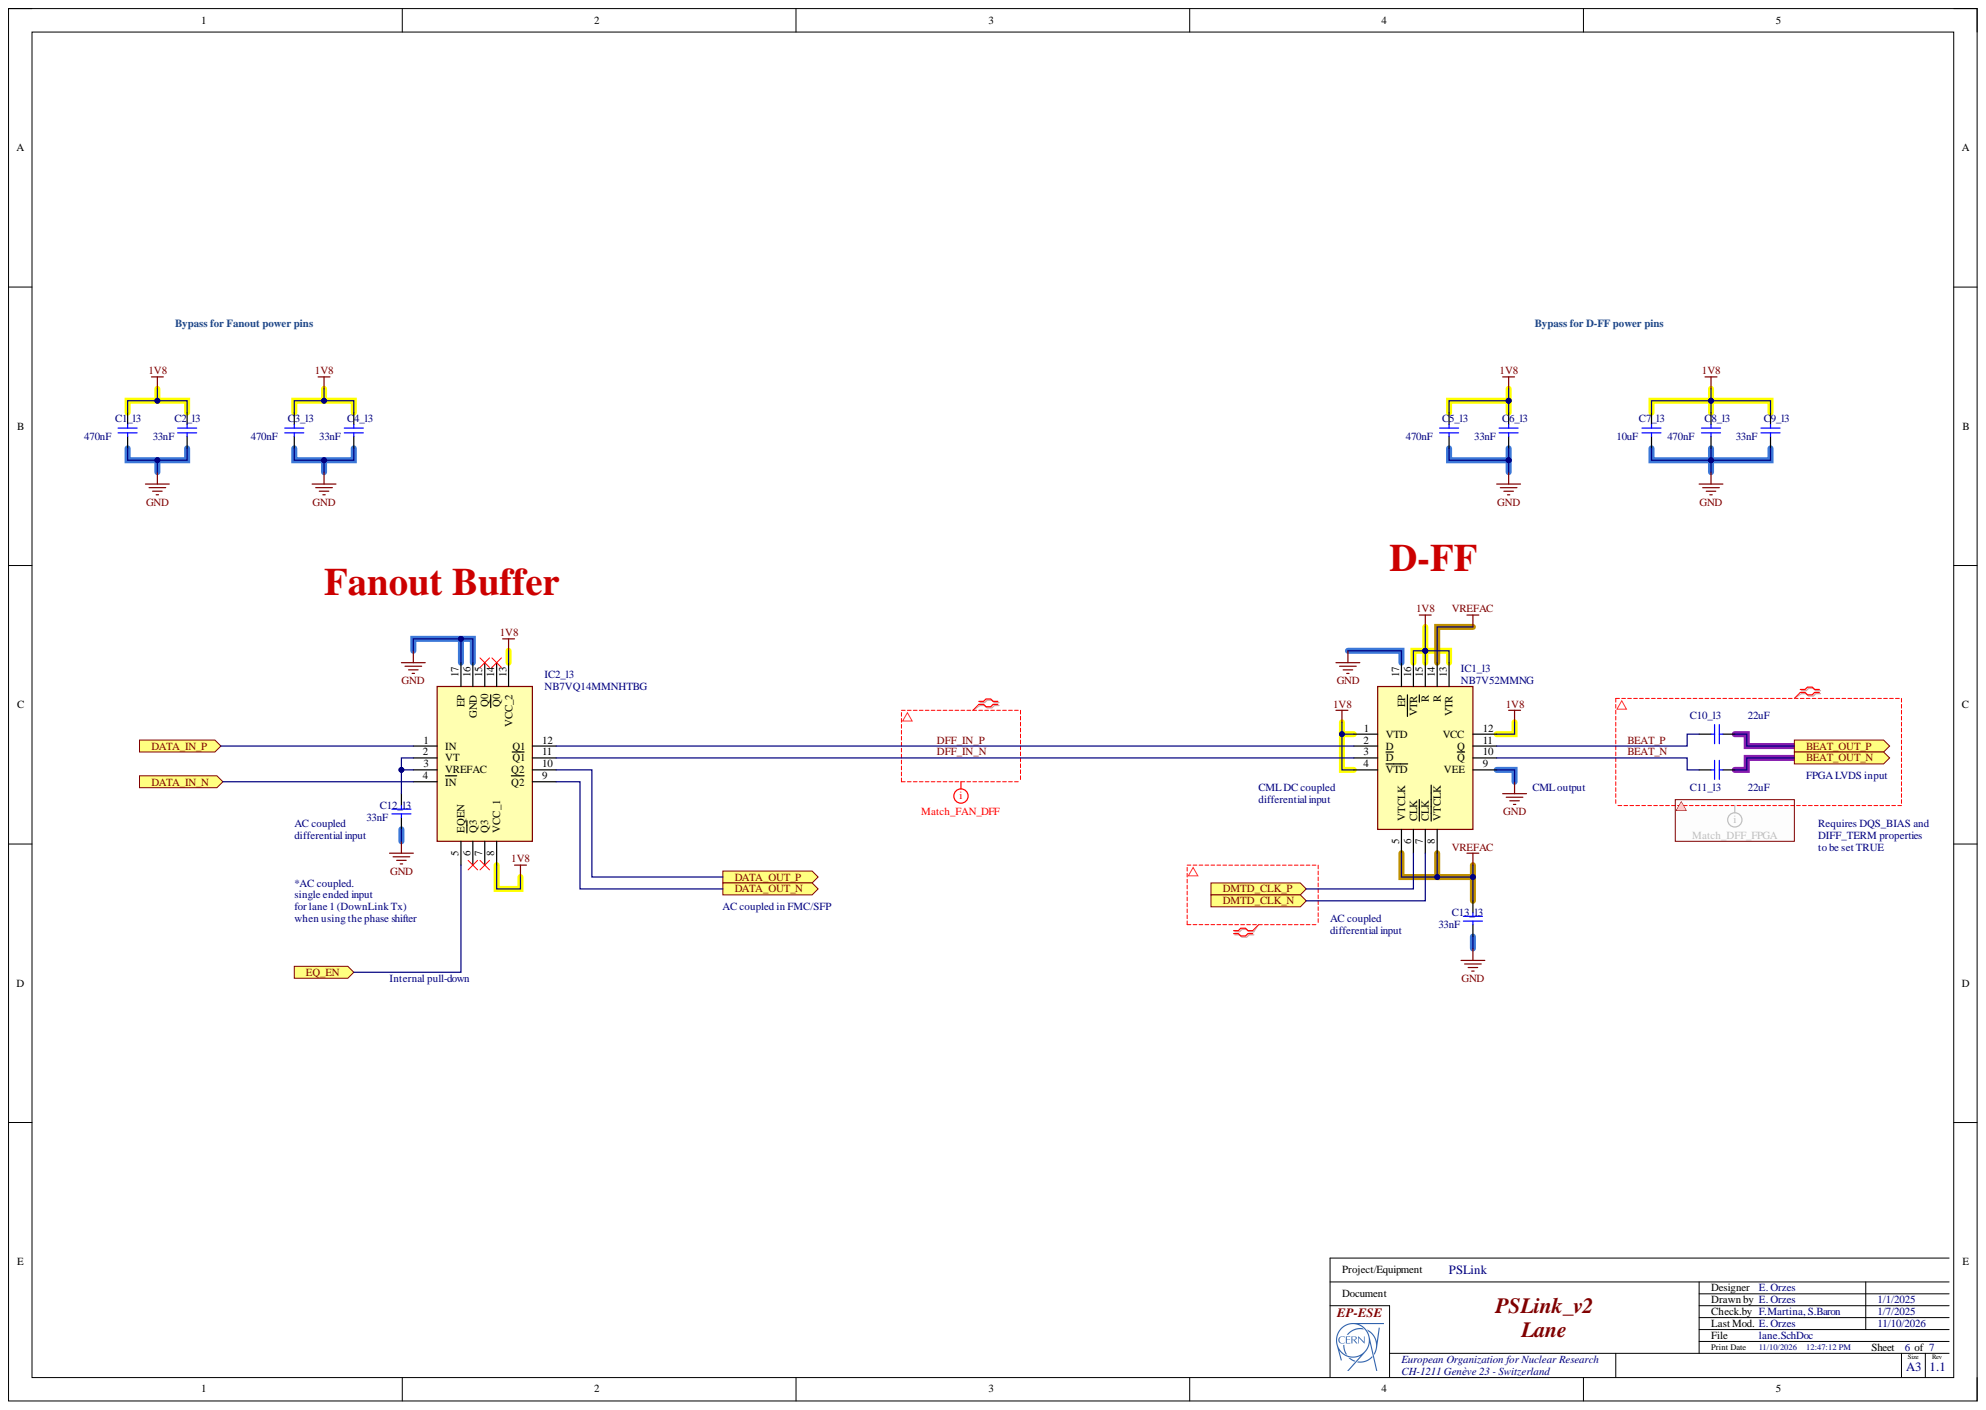
[picture p14: page 9]

Bypass for Fanout power pins

Bypass for D-FF power pins

Requires DQS_BIAS and
DIFF_TERM properties
to be set TRUE

*AC coupled.
single ended input
for lane 1 (DownLink Tx)
when using the phase shifter

Designer E. Orzes
Drawn by E. Orzes
Check.by F.Martina, S.Baron

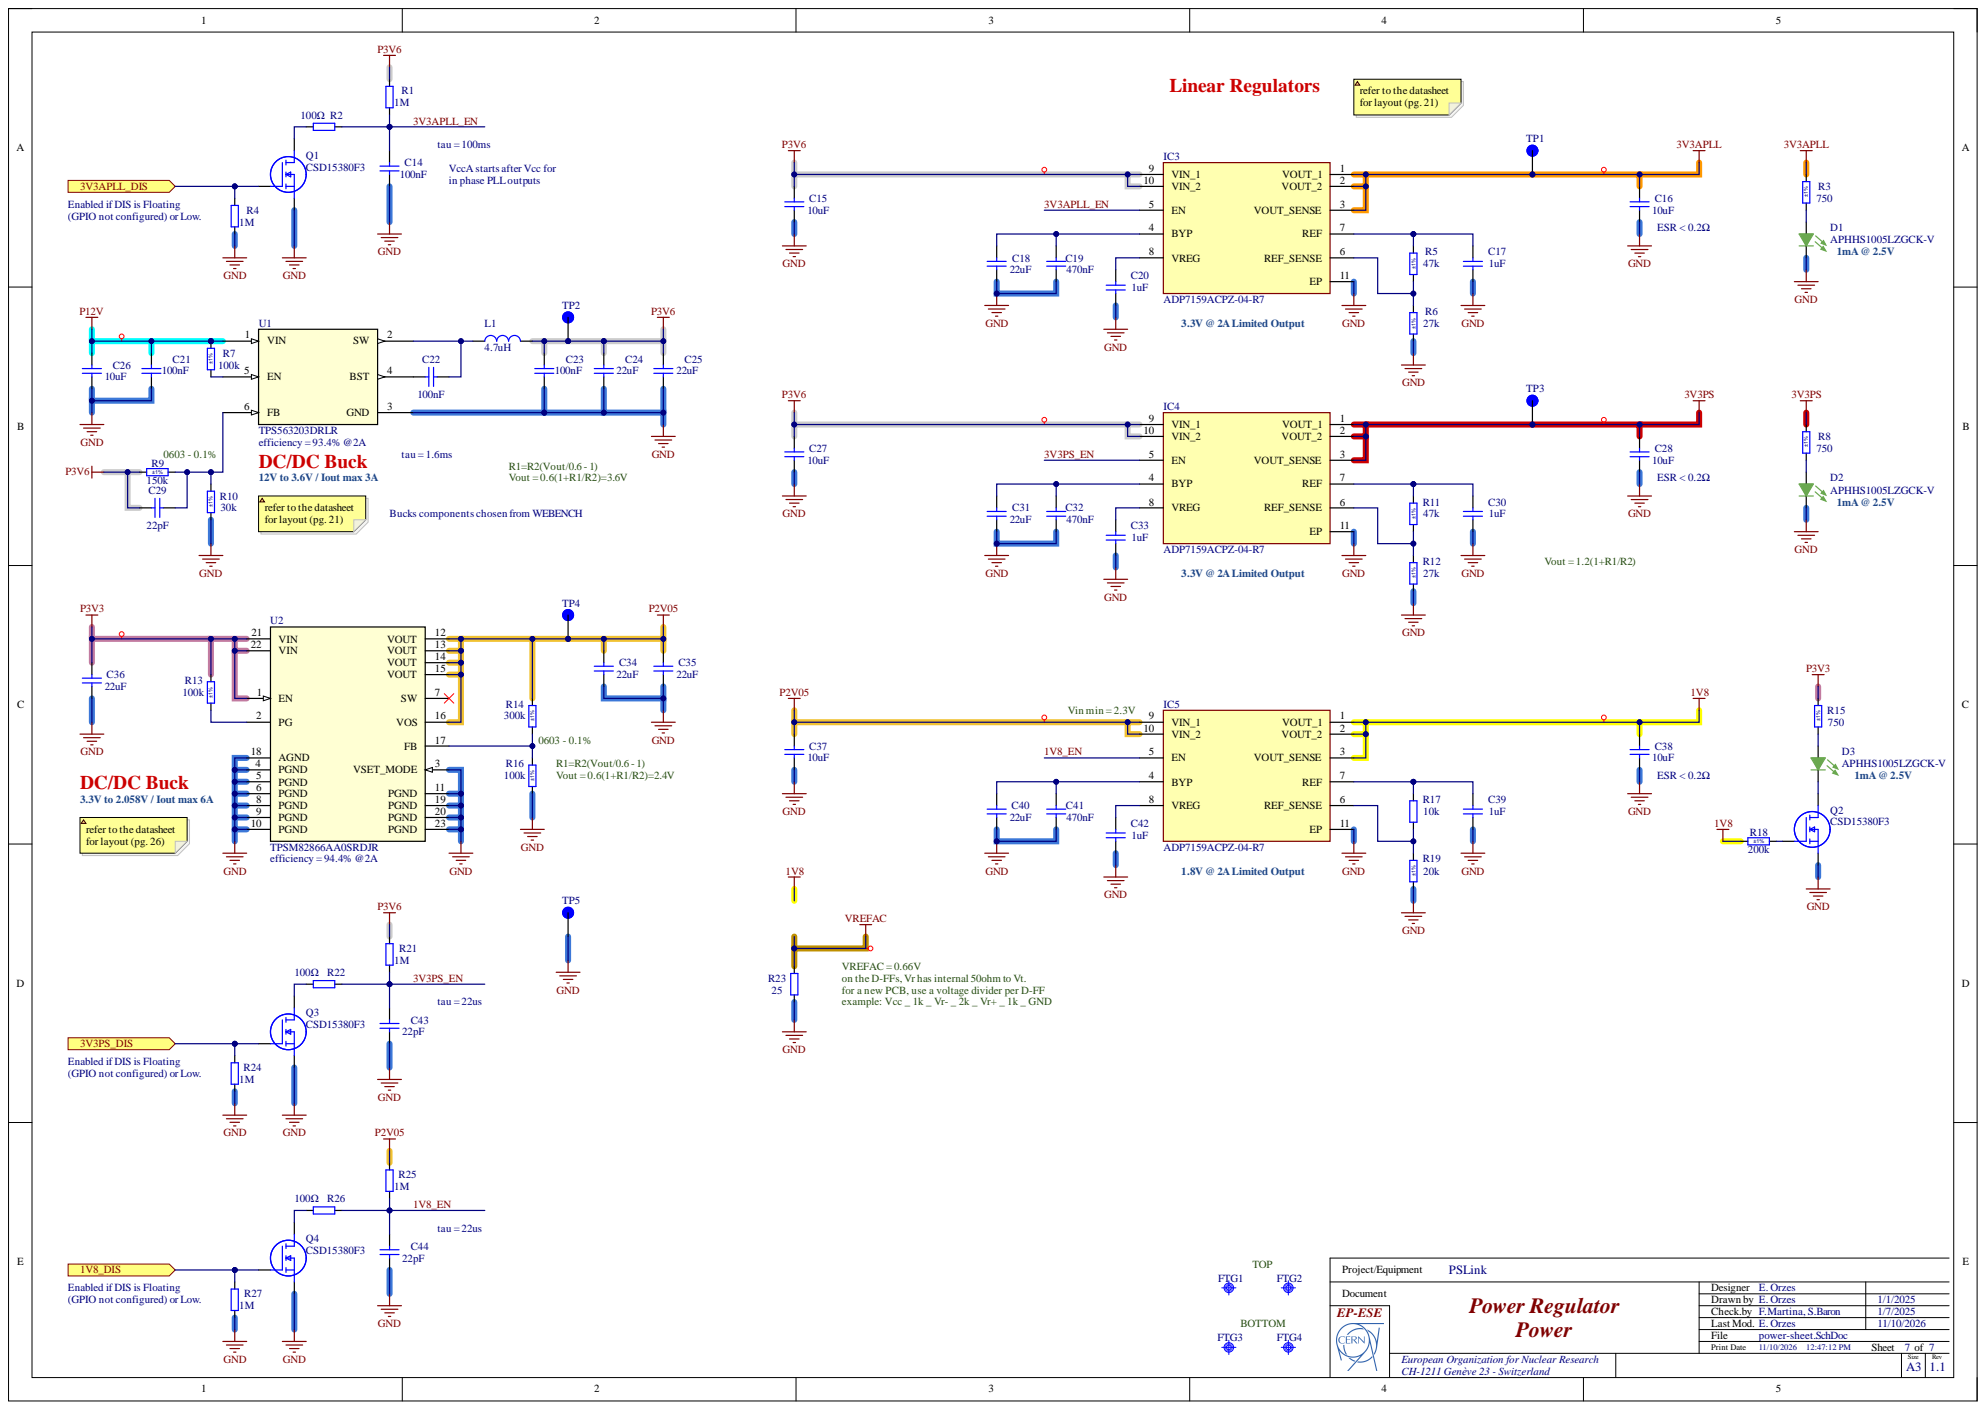
[picture p15: page 10]

VccA starts after Vcc for
in phase PLLou

3V3APLL_D
Enabled if DIS is Floating
(GPIO

not configured) or Lo

DC/DC Buck 3.3V to 2.058V / Iout max 6A

use a voltage divider per D-FF
