eorzes/PSLink_v2/(commit log)

2025-04-04 new buck
    [Channel.SchDoc, PLL.SchDoc, PSLink_v2.PrjPcb, SFP.SchDoc, phase-shifters.SchDoc, power-sheet.SchDoc]
2025-04-08 poly opt
    [FMC.SchDoc, power-sheet.SchDoc]
2025-04-10 voltage divider fix
    [power-sheet.SchDoc]
2025-04-15 annotation reset
    [Channel.SchDoc, FMC.SchDoc, PLL.SchDoc, PSLink_v2.PrjPcb, SFP.SchDoc, phase-shifters.SchDoc, power-sheet.SchDoc, top.SchDoc]
2025-04-15 channel renamed to lane
    [Channel.SchDoc, PSLink_v2.PrjPcb, lane.SchDoc, top.SchDoc]
2025-04-16 signature & silkscreen
    [PSLink_v2.PrjPcb, SFP.SchDoc, power-sheet.SchDoc]
2025-04-28 added testpoints
    [FMC.SchDoc, PSLink_v2.PrjPcb, phase-shifters.SchDoc, power-sheet.SchDoc]
